VikramP7/KeepTalkingPCB/Graphics/coilVPbit.bmp

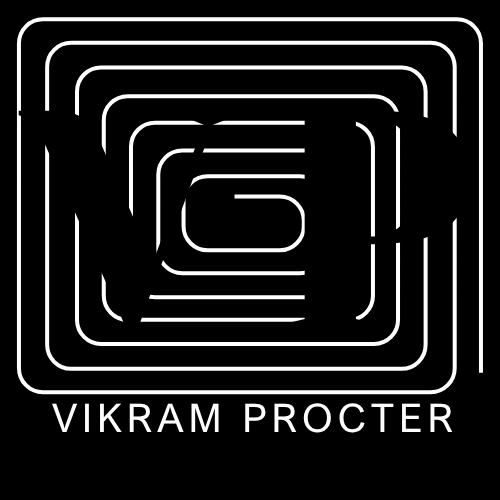
Graphics/coilVPbit.bmp
