VikramP7/KeepTalkingPCB/Graphics/Saturno_altium.png

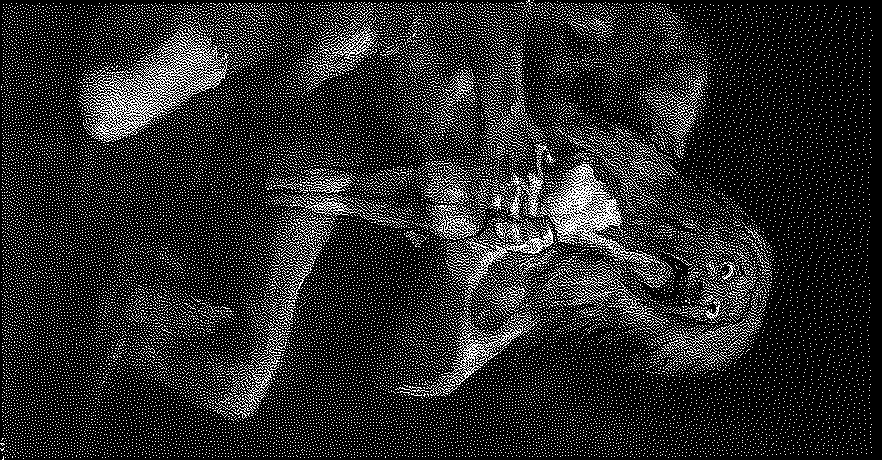
Graphics/Saturno_altium.png
