VikramP7/KeepTalkingPCB/Graphics/Saturno_display.png

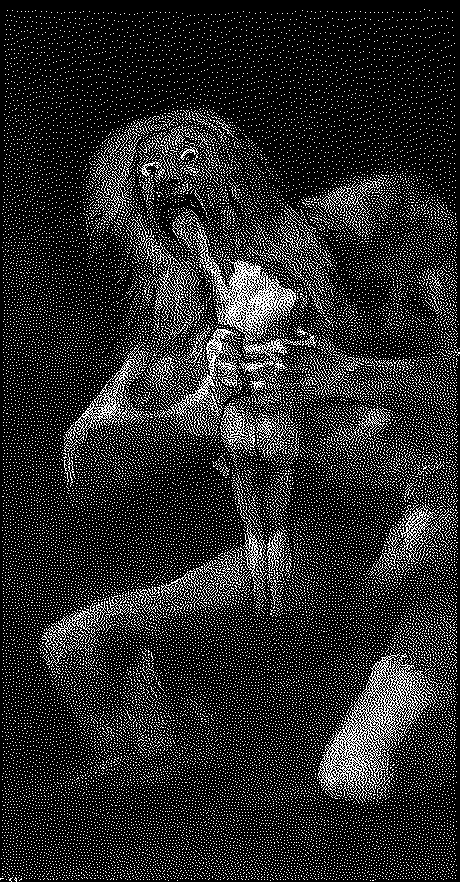
Graphics/Saturno_display.png
