VikramP7/KeepTalkingPCB/Graphics/Saturno_displayrot.png

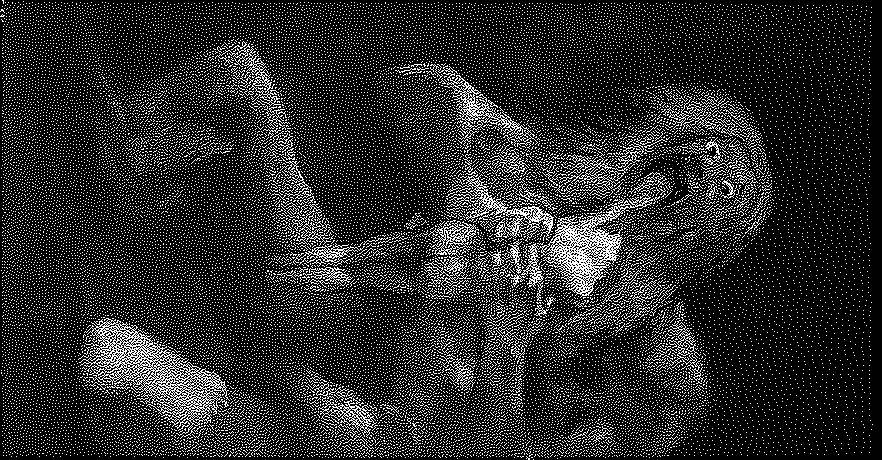
Graphics/Saturno_displayrot.png
