VikramP7/KeepTalkingPCB/Graphics/SaturnoJarvis_display.png

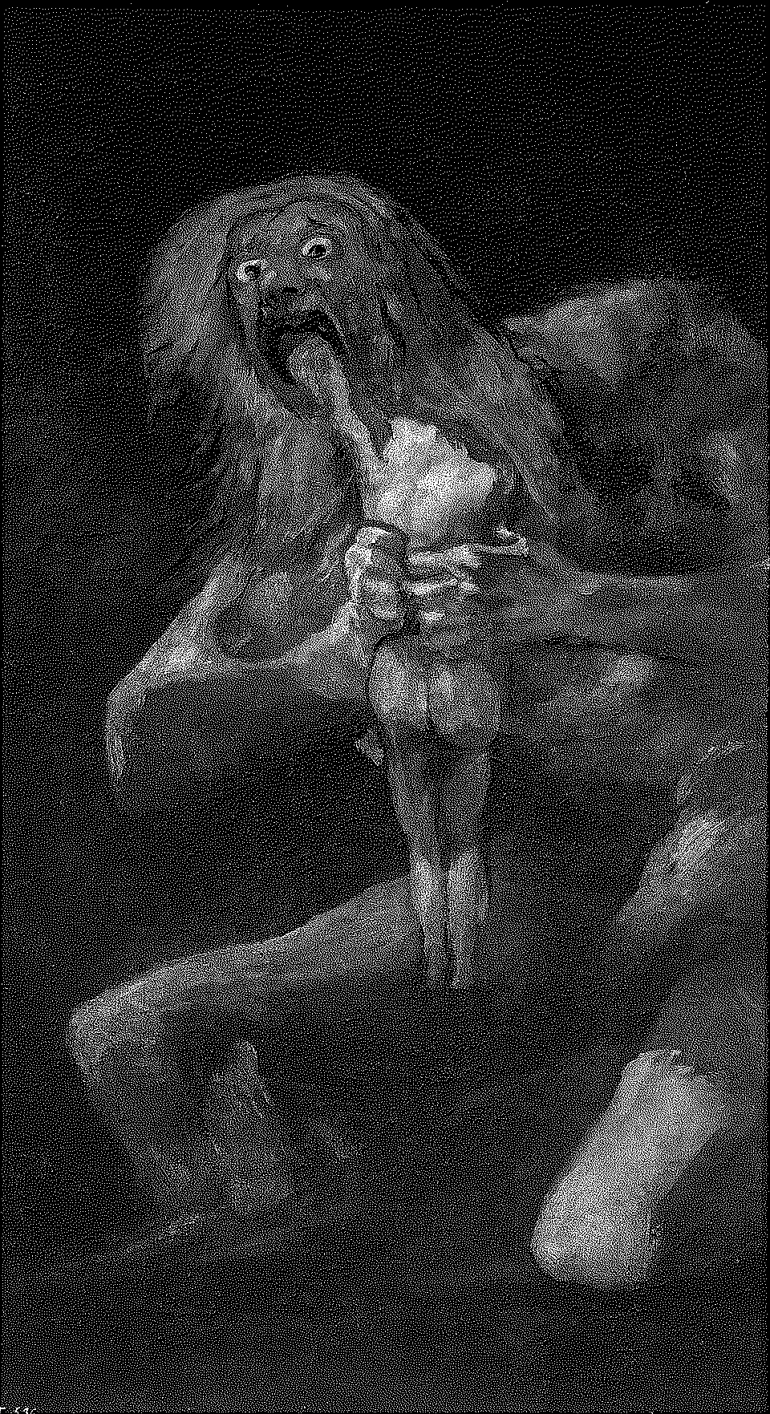
Graphics/SaturnoJarvis_display.png
