VikramP7/KeepTalkingPCB/KeepTalking_PCB/Project Outputs for KeepTalking_PCB/KeepTalking_PCB_BOM.xlsx

Supplier Part Number | Manufacturer Part Number | Manufacturer | Comment | Description | Designator | Footprint | LibRef | Quantity
311-1140-1-ND | CC0805KRX7R9BB104 | Yageo | 0.1uF | Ceramic Capacitor, Multilayer, Ceramic, 50V, 10% +Tol, 10% -Tol, X7R, 15% TC, 0.1uF, Surface Mount, 0805 | C1, C3, C6, C9, C10, C11, C12, C15 | 0805 | CAP CER 0.1uF 50V 0805 | 8
RB161MM-20CT-ND | RB161MM-20TR | Rohm | 1A | Rectifier Diode, Schottky, 1 Phase, 1 Element, 1A, 25V V(RRM), Silicon | D5, D6 | SOD-123F DIODE SCHOTTKY | Diode Schottky 25V 1A | 2
1276-1029-1-ND | CL21B105KBFNNNE | Samsung | 1uF | Ceramic Capacitor, Multilayer, Ceramic, 50V, 10% +Tol, 10% -Tol, X7R, 15% TC, 1uF, Surface Mount, 0805 | C2, C7, C14 | 0805 | CAP CER 1uF 50V 0805 | 3
SSM3J372RLFCT-ND | SSM3J372R,LF | Toshiba | 1.27mm | Power Field-Effect Transistor, 6A I(D), 30V, 0.042ohm, 1-Element, P-Channel, Silicon, Metal-oxide Semiconductor FET | J8 | CON 10PIN 2ROW 1.27MM | Con 10pos 2row Header 1.27mm Surface | 1
541-4.70KCCT-ND | CRCW08054K70FKEA | Vishay | 4.7k | Fixed Resistor, Metal Glaze/thick Film, 0.125W, 4700ohm, 150V, 1% +/-Tol, 100ppm/Cel, Surface Mount, 0805 | R18, R19, R20, R25 | 0805 | RES 4.7k 1% 0.125W 0805 | 4
1276-1244-1-ND | CL21A475KAQNNNE | Samsung | 4.7uF | Ceramic Capacitor, Multilayer, Ceramic, 25V, 10% +Tol, 10% -Tol, X5R, 15% TC, 4.7uF, Surface Mount, 0805 | C8, C13 | 0805 | CAP CER 4.7uF 50V 0805 | 2
277-1578-ND | 1935174 | Phoenix Contact | 5mm | Barrier Strip Terminal Block, 17.5A, 1.5mm2, 1 Row(s), 1 Deck(s) | J5 | CONN 3POS 5.00MM | CONN SCREW 3pos 5.0mm | 1
277-1768-ND | 1988846 | Phoenix Contact | 5mm | Barrier Strip Terminal Block, 17.5A, 2.5mm2, 1 Row(s), 1 Deck(s) | J1, J2 | CON 6POS SCREW 5.00MM | CONN SCREW 6pos 45Deg 5mm | 2
732-10955-ND | 691137710002 | Wurth Electronics | 5mm | Barrier Strip Terminal Block | J3, J4, J6 | CON 2POS SCREW 5.00MM | CON Screw 2Pos 5.00mm | 3
SSM3J372RLFCT-ND | SSM3J372R,LF | Toshiba | 6A | Power Field-Effect Transistor, 6A I(D), 30V, 0.042ohm, 1-Element, P-Channel, Silicon, Metal-oxide Semiconductor FET | PMOS1, PMOS2 | SOT-23F MOS PMOS 30V 6A | MOS PMOS 30V 6A | 2
P10KACT-ND | ERJ-6GEYJ103V | Panasonic | 10k | Fixed Resistor, Metal Glaze/thick Film, 0.125W, 10000ohm, 150V, 5% +/-Tol, 200ppm/Cel, Surface Mount, 0805 | R7, R8, R9, R10, R15, R21, R27, R29, R30, R31 | 0805 | RES 10k 5% 0.125W 0805 | 10
 |  |  | 16MHz |  | X1 | OSC 16MHZ | OSC 16MHz 18pF | 1
RG20P20.0KBCT-ND | RG2012P-203-B-T5 | Susumu | 20k | Fixed Resistor, Thin Film, 0.125W, 20000ohm, 150V, 0.1% +/-Tol, 25ppm/Cel, Surface Mount, 0805 | R1, R2, R3, R4, R5, R6, R22, R23, R24 | 0805 | RES 20K 0.1% 0.125W 0805 | 9
311-4231-1-ND | CC0805JRNPO9BN240 | Yageo | 24pF | CAP CER 24PF 50V NPO 0805 | C4, C5 | 0805 | CAP CER 24pF 5% 50V 0805 | 2
311-162CRCT-ND | RC0805FR-07162RL | Yageo | 162 | Fixed Resistor, Metal Glaze/thick Film, 0.125W, 162ohm, 150V, 1% +/-Tol, 100ppm/Cel, Surface Mount, 0805 | R11, R12, R13, R14, R16, R17 | 0805 | RES 162 1% 0.125W 0805 | 6
2223-SLW-1277545-2A-RA-S-D-ND | SLW-1277545-2A-RA-S-D | Same Sky | 300mA | 12.7 x 7.5 x 4.5 mm, 2 mm Raised Slide Actuator, Right Angle, Through Hole, Slide Switch | SW7 | SWITCH ON-ON-ON 300MA SLW-1277545-2A-RA-S-D | SW On-On-On 300mA | 1
311-536CRCT-ND | RC0805FR-07536RL | Yageo | 536 | Fixed Resistor, Metal Glaze/thick Film, 0.125W, 536ohm, 150V, 1% +/-Tol, 100ppm/Cel, Surface Mount, 0805 | R26, R28 | 0805 | RES 536 1% 0.125W 0805 | 2
102-1153-ND | CEM-1203(42) | Same Sky | CEM-1203(42) | Audio Signaling/Alarm Devices | LS1 | BUZZER CEM-1203(42) | LS Buzzer CEM-1203(42) | 1
1727-3578-1-ND | IP4220CZ6,125 | Nexperia | IP4220CZ6,125 | Trans Voltage Suppressor Diode, Unidirectional, 1 Element, Silicon | U9 | SOT-457 USB ESD | IC USB Dual ESD Protec IP4220CZ6,125 | 1
2521-IS31FL3731-SALS2-TRCT-ND | IS31FL3731-SALS2-TR | ISSI | IS31FL3731-SALS2-TR | LED Driver, 144-Segment, PDSO28 | U6 | 28-SSOP LED MATRIX DRIVER | IC MatrixDriv IS31FL3731-SALS2-TR | 1
497-17239-1-ND | LDL1117S33R | STMicroelectronics | LDL1117S33R | Fixed Positive LDO Regulator, 3.3V, 0.6V Dropout, PDSO4 | U7 | SOT-223 LIN REG 3V3 | IC LIN REG 3V3 LDL1117S33R | 1
 |  |  | LED Matrix |  | DS2 | LED MATRIX 9X16 CHARLIE | LEDARR 2973 9X16 | 1
WM17144CT-ND | 47590-0001 | Molex | micro ab | USB Connector, 5 Contact(s), Female, Right Angle, Surface Mount Terminal, Locking, Receptacle | J7 | USB MICRO AB 0475900001 | CON USB micro ab | 1
DMG1012UW-7DICT-ND | DMG1012UW-7 | Diodes Zetex | NMOS | Small Signal Field-Effect Transistor, 1A I(D), 20V, 1-Element, N-Channel, Silicon, Metal-oxide Semiconductor FET | Q1, Q2, Q3, Q4, Q5, Q6, Q7 | SOT-323 MOS | MOS NMOS 20V 1A SOT323 | 7
MMBT3904TPMSCT-ND | MMBT3904-TP | MCC | npn MMBT3904-TP | Small Signal Bipolar Transistor, 0.2A I(C), 40V V(BR)CEO, 1-Element, NPN, Silicon | T1 | SOT-23 TRANSISTOR | T npn 40V 0.2A | 1
450-1158-ND | FSM103 | TE Connectivity Alcoswitch | Off-Mom | Pushbutton Switch, SPST, Momentary-tactile, 0.05A, Solder Terminal, Through Hole-straight | SW6 | SWITCH OFF-MOM | SW Off-Mom Through | 1
108-OS102011MA1QN1C-ND | OS102011MA1QN1C | ITT C&K | OS102011MA1QN1 | Slide Switch, 2 Positions, SPDT, On-on, Latched, 0.1A, 12VDC, 5 PCB Hole Cnt, Solder Terminal, Through Hole-right Angle | SW5 | OS102011MA1QN1 | SW 2pos Through RightAngle | 1
 |  |  | Oval |  | SW1, SW2, SW3, SW4 | OVAL BUTTON | SW Off-Mom OvalPush | 4
160-1412-1-ND | LTST-C170KAKT | Vishay Lite-On | Red 2V | Single Color LED, Red Orange, Water Clear, 1.4mm | D7, D8, D9, D10, D11, D12 | 0805 | DIO LED RED 2V 0805 | 6
CLMVC-FKA-CL1D1L71BB7C3C3CT-ND | CLMVC-FKA-CL1D1L71BB7C3C3 | Cree | RGB LED | Visible LED | D1, D2, D3, D4 | RBG LED 4-SMD | DI LED RGB ComAnode | 4
296-9138-1-ND | SN74CBTLV3257PWR | Texas Instruments | SN74CBTLV3257PWR | Multiplexer And Demux/Decoder, CBTLV/3B Series, 4-Func, 1 Line Input, 2 Line Output, True Output, CMOS, PDSO16 | U3 | 16-TSSOP 1:2 SWITCH SN74CBTLV3257PWR | IC 1:2 Switch SN74CBTLV3257PWR | 1
296-46894-1-ND | SN74LS47DR | Texas Instruments | SN74LS47DR | Seven Segment Decoder/Driver, LS Series, Inverted Output, TTL, PDSO16 | U4 | 16-SOIC 7-SEG DRIVER | IC DRVR 7 SEG SN74LS47DR | 1
296-3829-1-ND | SN74LV4051APWR | Texas Instruments | SN74LV4051APWR | Single-Ended Multiplexer, 1 Func, 8 Channel, CMOS, PDSO16 | U2, U5 | 16-TSSOP MUX 8TO1 | IC MUX 8:1 SN74LV4051APWR | 2
497-18227-ND | STM32L412CBT6 | STMicroelectronics | STM32L412CBT6 | RISC Microcontroller | U1 | 48-LQFP | IC STM32L412CBT6 | 1
TDCR1060M-ND | TDCR1060M | Vishay | TDCR1060M | Clock LED Display, 4-Character, Red, 10mm | DS1 | 16-DIP 4CHAR-7SEG | DISP 7-seg 4Char Clock | 1
296-25565-1-ND | TLC59401PWPR | Texas Instruments | TLC59401PWPR | LED Driver, 16-Segment, PDSO28 | U8 | 28-HTSSOP 16LED DRIVER | IC 16LED Driver TLC59401PWPR | 1
