VikramP7/KeepTalkingPCB/DigikeyCart.xlsx

Index | Quantity | Part Number | Manufacturer Part Number | Description | Customer Reference | Available | Backorder | Unit Price | Extended Price CAD
1 | 20 | 311-1140-1-ND | CC0805KRX7R9BB104 | CAP CER 0.1UF 50V X7R 0805 | C1, C3, C6, C9, C10, C11, C12, C15 | 20 | 0 | 0.032 | 0.64
2 | 4 | RB161MM-20CT-ND | RB161MM-20TR | DIODE SCHOTTKY 25V 1A PMDU | D5, D6 | 4 | 0 | 0.69 | 2.76
3 | 10 | 1276-1029-1-ND | CL21B105KBFNNNE | CAP CER 1UF 50V X7R 0805 | C2, C7, C14 | 10 | 0 | 0.027 | 0.27
4 | 2 | SSM3J372RLFCT-ND | SSM3J372R,LF | MOSFET P-CH 30V 6A SOT23F | J8 | 2 | 0 | 0.52 | 1.04
5 | 10 | 541-4.70KCCT-ND | CRCW08054K70FKEA | RES SMD 4.7K OHM 1% 1/8W 0805 | R18, R19, R20, R25 | 10 | 0 | 0.063 | 0.63
6 | 10 | 1276-1244-1-ND | CL21A475KAQNNNE | CAP CER 4.7UF 25V X5R 0805 | C8, C13 | 10 | 0 | 0.082 | 0.82
7 | 2 | 277-1578-ND | 1935174 | TERM BLK 3POS SIDE ENTRY 5MM PCB | J5 | 2 | 0 | 1.5 | 3.00
8 | 4 | 277-1768-ND | 1988846 | TERM BLOCK 6POS 45DEG 5MM PCB | J1, J2 | 4 | 0 | 2.7 | 10.80
9 | 6 | 732-10955-ND | 691137710002 | TERM BLK 2POS SIDE ENTRY 5MM PCB | J3, J4, J6 | 6 | 0 | 0.52 | 3.12
10 | 4 | SSM3J372RLFCT-ND | SSM3J372R,LF | MOSFET P-CH 30V 6A SOT23F | PMOS1, PMOS2 | 4 | 0 | 0.52 | 2.08
11 | 25 | P10KACT-ND | ERJ-6GEYJ103V | RES SMD 10K OHM 5% 1/8W 0805 | R7, R8, R9, R10, R15, R21, R27, R29, R30, R31 | 25 | 0 | 0.048 | 1.20
12 | 2 | 535-9071-1-ND | ABLS-16.000MHZ-B2-T | CRYSTAL 16.0000MHZ 18PF SMD | X1 | 2 | 0 | 0.38 | 0.76
13 | 20 | RG20P20.0KBCT-ND | RG2012P-203-B-T5 | RES SMD 20K OHM 0.1% 1/8W 0805 | R1, R2, R3, R4, R5, R6, R22, R23, R24 | 20 | 0 | 0.129 | 2.58
14 | 10 | 311-4231-1-ND | CC0805JRNPO9BN240 | CAP CER 24PF 50V C0G/NPO 0805 | C4, C5 | 10 | 0 | 0.096 | 0.96
15 | 16 | 311-162CRCT-ND | RC0805FR-07162RL | RES 162 OHM 1% 1/8W 0805 | R11, R12, R13, R14, R16, R17 | 16 | 0 | 0.02 | 0.32
16 | 2 | 2223-SLW-1277545-2A-RA-S-D-ND | SLW-1277545-2A-RA-S-D | 12.7 X 7.5 X 4.5 MM, 2 MM RAISED | SW7 | 2 | 0 | 0.56 | 1.12
17 | 10 | 311-536CRCT-ND | RC0805FR-07536RL | RES 536 OHM 1% 1/8W 0805 | R26, R28 | 10 | 0 | 0.02 | 0.20
18 | 2 | 1727-3578-1-ND | IP4220CZ6,125 | TVS DIODE 5.5VWM 6TSOP | U9 | 2 | 0 | 0.4 | 0.80
19 | 2 | 2521-IS31FL3731-SALS2-TRCT-ND | IS31FL3731-SALS2-TR | IC LED DRV LIN ANALOG 28SSOP | U6 | 2 | 0 | 4.1 | 8.20
20 | 2 | 497-17239-1-ND | LDL1117S33R | IC REG LINEAR 3.3V 1.2A SOT-223 | U7 | 2 | 0 | 0.55 | 1.10
21 | 2 | WM17144CT-ND | 0475900001 | CONN RCPT MICRO USB AB 5P SMD RA | J7 | 2 | 0 | 1.08 | 2.16
22 | 14 | DMG1012UW-7DICT-ND | DMG1012UW-7 | MOSFET N-CH 20V 1A SOT323 | Q1, Q2, Q3, Q4, Q5, Q6, Q7 | 14 | 0 | 0.187 | 2.62
23 | 2 | MMBT3904TPMSCT-ND | MMBT3904-TP | TRANS NPN 40V 0.2A SOT-23 | T1 | 2 | 0 | 0.15 | 0.30
24 | 2 | 450-1158-ND | FSM103 | SWITCH TACTILE SPST-NO 0.05A 24V | SW6 | 2 | 0 | 0.61 | 1.22
25 | 2 | CKN9559-ND | OS102011MA1QN1 | SWITCH SLIDE SPDT 100MA 12V | SW5 | 2 | 0 | 0.91 | 1.82
26 | 10 | EG5384CT-ND | TL3365AF180QG | SWITCH TACTILE SPST-NO 0.05A 12V | SW1, SW2, SW3, SW4 | 10 | 0 | 0.278 | 2.78
27 | 16 | 160-1412-1-ND | LTST-C170KAKT | LED RED-ORANGE CLEAR SMD | D7, D8, D9, D10, D11, D12 | 16 | 0 | 0.235 | 3.76
28 | 8 | CLMVC-FKA-CL1D1L71BB7C3C3CT-ND | CLMVC-FKA-CL1D1L71BB7C3C3 | LED RGB CLEAR 4PLCC SMD | D1, D2, D3, D4 | 8 | 0 | 0.35 | 2.80
29 | 2 | 296-9138-1-ND | SN74CBTLV3257PWR | IC MUX/DEMUX 4 X 1:2 16-TSSOP | U3 | 2 | 0 | 0.69 | 1.38
30 | 2 | 296-46894-1-ND | SN74LS47DR | IC DRVR 7 SEGMENT 16SOIC | U4 | 2 | 0 | 2.04 | 4.08
31 | 4 | 296-3829-1-ND | SN74LV4051APWR | IC MUX 8:1 75OHM 16TSSOP | U2, U5 | 4 | 0 | 0.41 | 1.64
32 | 2 | 497-18227-ND | STM32L412CBT6 | IC MCU 32BIT 128KB FLASH 48LQFP | U1 | 2 | 0 | 5.95 | 11.90
33 | 2 | TDCR1060M-ND | TDCR1060M | DISP 7SEG 0.39" QUAD RED 16DIP | DS1 | 2 | 0 | 5.12 | 10.24
34 | 2 | 296-25565-1-ND | TLC59401PWPR | IC LED DRVR LIN 120MA 28HTSSOP | U8 | 2 | 0 | 3.93 | 7.86
35 | 2 | 1528-1639-ND | 2974 | LED CHARLIEPLEXED MATRIX - 9X16 | DS2 | 2 | 0 | 12.19 | 24.38
36 | 1 | 497-STLINK-V3MINIE-ND | STLINK-V3MINIE | ST-LINK V3 PROG FOR STM32 |  | 1 | 0 | 16.89 | 16.89
37 | 2 | 2223-CMI-1295IC-0385T-ND | CMI-1295IC-0385T | BUZZER MAGNETIC 3V 12MM TH | LS1 | 2 | 0 | 1.96 | 3.92
