VikramP7/KeepTalkingPCB/(list of files, drawings)

Other design files:
KeepTalking_PCB/KeepTalking_PCB.PrjPcb
KeepTalking_PCB/PcbLib1.PcbLib
KeepTalking_PCB/Schlib1.SchLib
KeepTalking_PCB/TopLevel.SchDoc
