VikramP7/KeepTalkingPCB/KeepTalking/Core/Inc/main.h

#define ADC1_IN5_Fake_Batt_Pin GPIO_PIN_0
#define ADC1_IN5_Fake_Batt_GPIO_Port GPIOA
#define Wires_Input1_Pin GPIO_PIN_1
#define Wires_Input1_GPIO_Port GPIOA
#define Wires_Input2_Pin GPIO_PIN_2
#define Wires_Input2_GPIO_Port GPIOA
#define Wires_Input3_Pin GPIO_PIN_3
#define Wires_Input3_GPIO_Port GPIOA
#define Wires_Input4_Pin GPIO_PIN_4
#define Wires_Input4_GPIO_Port GPIOA
#define Wires_Input5_Pin GPIO_PIN_5
#define Wires_Input5_GPIO_Port GPIOA
#define Wires_Input6_Pin GPIO_PIN_6
#define Wires_Input6_GPIO_Port GPIOA
#define Red_Button_Input_Pin GPIO_PIN_7
#define Red_Button_Input_GPIO_Port GPIOA
#define Expan_Output_Pin GPIO_PIN_0
#define Expan_Output_GPIO_Port GPIOB
#define LPTM1_Out_Buzz_Pin GPIO_PIN_2
#define LPTM1_Out_Buzz_GPIO_Port GPIOB
#define LED_Out_Mode_Pin GPIO_PIN_10
#define LED_Out_Mode_GPIO_Port GPIOB
#define LED_Out_XLAT_Pin GPIO_PIN_11
#define LED_Out_XLAT_GPIO_Port GPIOB
#define Seg_7_Drv_OutputA_Pin GPIO_PIN_12
#define Seg_7_Drv_OutputA_GPIO_Port GPIOB
#define Seg_7_OutputB_Pin GPIO_PIN_13
#define Seg_7_OutputB_GPIO_Port GPIOB
#define Seg_8_OutputC_Pin GPIO_PIN_14
#define Seg_8_OutputC_GPIO_Port GPIOB
#define Seg_7_OutputD_Pin GPIO_PIN_15
#define Seg_7_OutputD_GPIO_Port GPIOB
#define LPTIM2_Out_GSCLK_Pin GPIO_PIN_8
#define LPTIM2_Out_GSCLK_GPIO_Port GPIOA
#define Matrix_SDB_Output_Pin GPIO_PIN_11
#define Matrix_SDB_Output_GPIO_Port GPIOA
#define Matrix_INTB_Input_Pin GPIO_PIN_12
#define Matrix_INTB_Input_GPIO_Port GPIOA
#define Sev_Seg_Mux_Output0_Pin GPIO_PIN_5
#define Sev_Seg_Mux_Output0_GPIO_Port GPIOB
#define Sev_Seg_Mux_Output1_Pin GPIO_PIN_6
#define Sev_Seg_Mux_Output1_GPIO_Port GPIOB
#define Sev_Seg_Mux_Output2_Pin GPIO_PIN_7
#define Sev_Seg_Mux_Output2_GPIO_Port GPIOB
#define LED_Out_Sin_Pin GPIO_PIN_8
#define LED_Out_Sin_GPIO_Port GPIOB
#define LED_Out_SCLK_Pin GPIO_PIN_9
#define LED_Out_SCLK_GPIO_Port GPIOB
