VikramP7/KeepTalkingPCB/(notices)

Notices in the files:
KeepTalking/Core/Inc/main.h:
Copyright (c) 2025 STMicroelectronics.
All rights reserved.
This software is licensed under terms that can be found in the LICENSE file
